Taewoo0927/Clean_bot/References/Self-learn/Makefile_Tutorial.txt

# Essential Makefile Codes for Embedded Projects: A Step-by-Step Guide

This tutorial lists the most important Makefile codes you need for creating a versatile Makefile, suitable for any microcontroller project without using an IDE.

---

## 1. Define the Compiler
```
CC = msp430-elf-gcc
```
- Specifies the compiler to use (`msp430-elf-gcc` for MSP430). Change this based on your microcontroller (e.g., `arm-none-eabi-gcc` for ARM Cortex).

---

## 2. Set the Microcontroller Model
```
MCU = msp430g2553
```
- Defines the specific microcontroller model. This is used in compiler and linker flags for device-specific settings.

---

## 3. Specify Include Paths
```
INCLUDE_PATH = C:/ti/msp430-gcc/include
CFLAGS = -I$(INCLUDE_PATH)
```
- Adds the directory where header files (e.g., `msp430.h`) are located. Adjust based on your toolchain's include directory.

---

## 4. Define Compiler Flags
```
CFLAGS += -mmcu=$(MCU) -Wall -O2
```
- Sets compiler options, such as specifying the MCU model (`-mmcu`), enabling all warnings (`-Wall`), and optimizing code (`-O2`).

---

## 5. Define Linker Flags
```
LDFLAGS = -T linker_script.ld
```
- Specifies linker options, including the custom linker script (`-T linker_script.ld`). This script controls memory layout.

---

## 6. List the Source Files
```
SRC = src/main.c src/adc.c src/i2c.c
```
- Defines all source files in the project. Add your `.c` files here.

---

## 7. Generate Object Files List
```
OBJ = $(SRC:.c=.o)
```
- Automatically generates the list of object files by replacing `.c` with `.o` in the source files list.

---

## 8. Define the Output Executable
```
TARGET = build/main.elf
```
- Specifies the output executable file (e.g., `main.elf`). Store it in a `build/` directory for organization.

---

## 9. Create the Build Directory
```
$(BUILD_DIR):
    mkdir -p $(BUILD_DIR)
```
- Creates the build directory if it does not already exist. This is helpful for organizing compiled files.

---

## 10. Compile Source Files into Object Files
```
%.o: %.c
    $(CC) $(CFLAGS) -c $< -o $@
```
- Compiles each `.c` file into an object file (`.o`). The `$<` is the input file, and `$@` is the output file.

---

## 11. Link Object Files into Executable
```
$(TARGET): $(OBJ)
    $(CC) $(CFLAGS) $(LDFLAGS) -o $(TARGET) $(OBJ)
```
- Links all object files into the final executable (`.elf` file).

---

## 12. Convert ELF File to HEX or TI-TXT Format
```
HEX_FILE = build/main.hex
$(HEX_FILE): $(TARGET)
    msp430-elf-objcopy -O ihex $(TARGET) $(HEX_FILE)
```
- Converts the ELF file to Intel HEX format (`.hex`) or TI-TXT format (`.txt`) for flashing.

---

## 13. Flash the Microcontroller
```
flash: $(HEX_FILE)
    C:/ti/MSPFlasher_1.3.20/MSP430Flasher.exe -n $(MCU) -w $(HEX_FILE) -v -g
```
- Uses the flasher tool to upload the HEX or TXT file to the microcontroller.

---

## 14. Clean Up Build Files
```
clean:
    rm -f $(OBJ) $(TARGET) $(HEX_FILE)
```
- Deletes all generated files (object files, ELF file, HEX file) to start a fresh build.

---

## 15. Force Rebuild of All Files
```
.PHONY: clean all
```
- Ensures that `clean` and `all` targets are always executed, even if files with the same names exist.

---

# Bonus Tips: Adding Custom Flags for Debugging

## 16. Enable Debugging Symbols
```
CFLAGS += -g
```
- Adds debugging information to the compiled code, making it easier to debug with tools like GDB.

---

## 17. Enable Verbose Output
```
VERBOSE = 1
$(TARGET): $(OBJ)
    $(CC) $(CFLAGS) $(LDFLAGS) -o $(TARGET) $(OBJ)
ifeq ($(VERBOSE), 1)
    @echo "Linking complete: $(TARGET)"
endif
```
- Prints additional information during the build process if `VERBOSE` is set to `1`.

---

# Summary
These Makefile codes provide a comprehensive and flexible setup for any microcontroller project, allowing you to:
- Compile, link, and flash your code without an IDE.
- Easily adjust the compiler, source files, and flags for different microcontrollers.
- Organize your project files efficiently and automate the build process.

With these commands, you can quickly set up and build embedded projects using just the terminal, giving you a lightweight and portable development workflow.
