Taewoo0927/Clean_bot/PCB_design/clean_bot/CAD_IMG/Final pcb.png

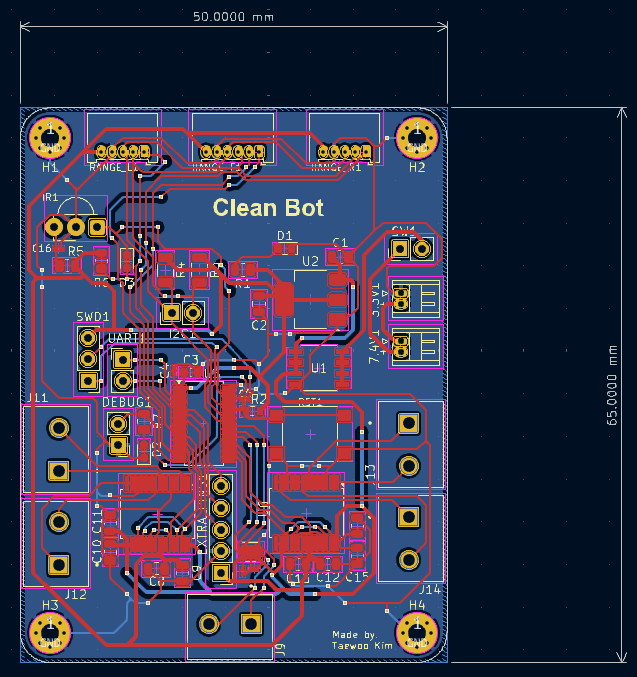
PCB_design/clean_bot/CAD_IMG/Final pcb.png
