Taewoo0927/Clean_bot/References/Code-Architecture/Code-Architecture.jpg

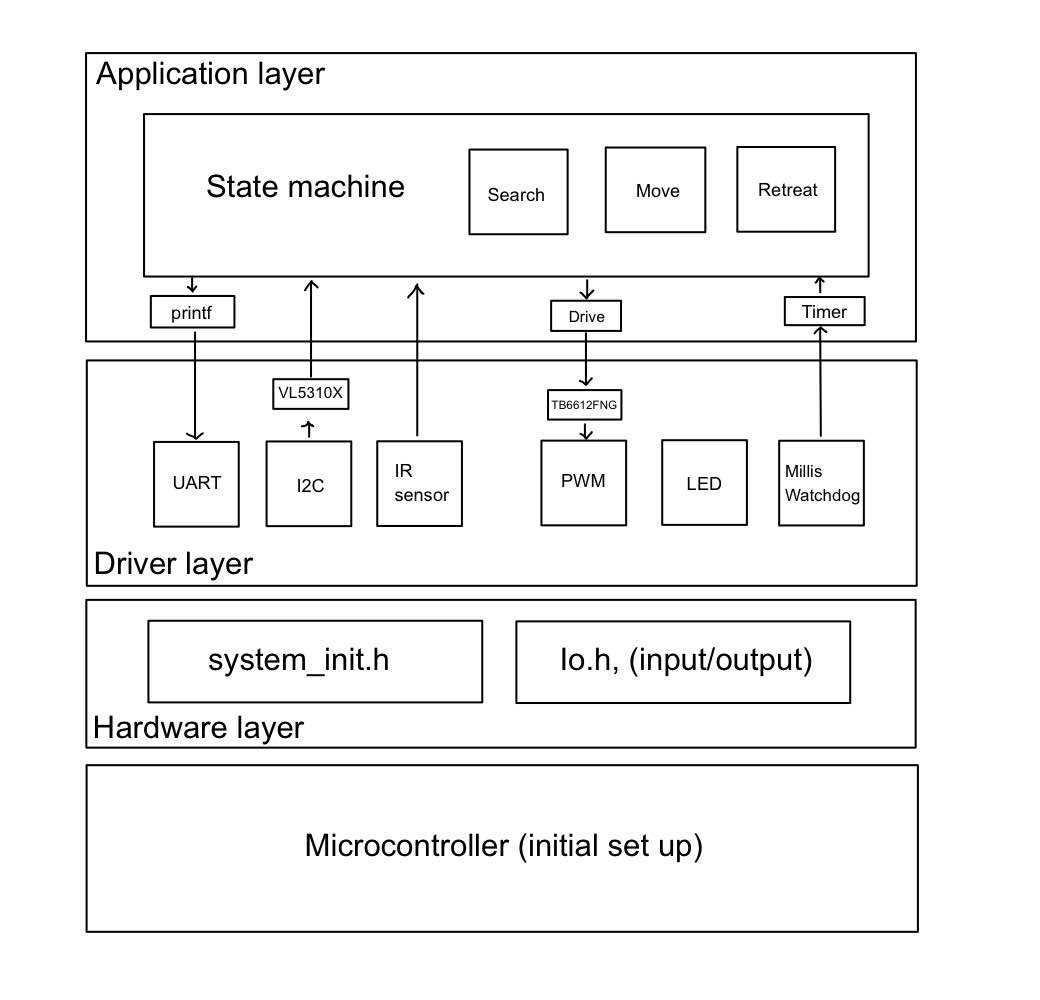
References/Code-Architecture/Code-Architecture.jpg
