Taewoo0927/Clean_bot/PCB_design/clean_bot/clean_bot.kicad_pcb

## KiCad design PCB_design/clean_bot/clean_bot.kicad_pcb (2024-11-16)

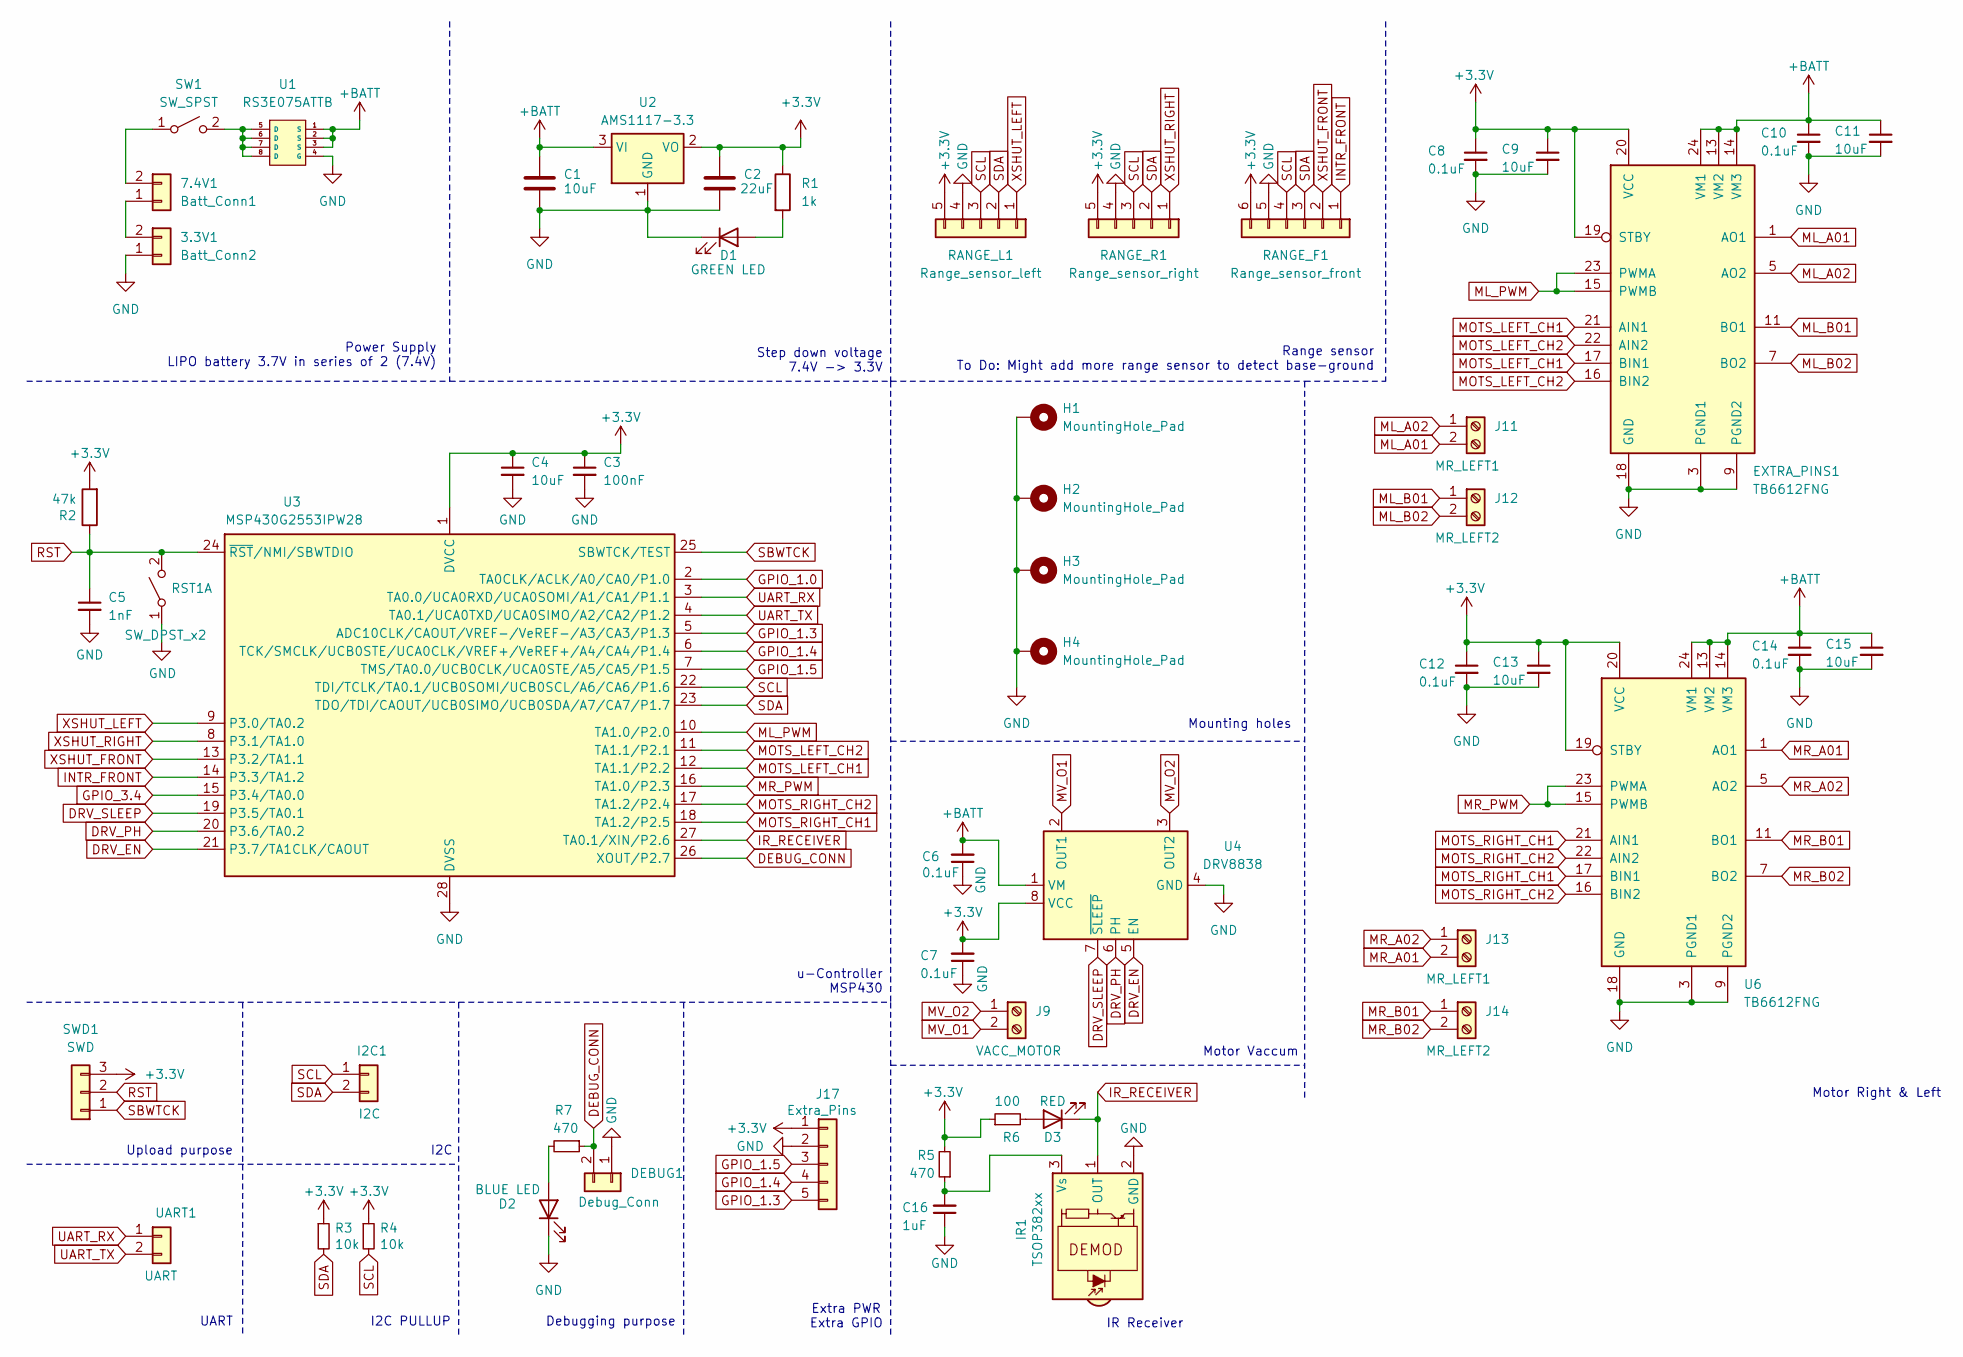
[picture p3: schematic clean_bot.kicad_sch]

Parts:
3.3V1: Batt_Conn2; Hirose_DF13-02P-1.25DS_1x02_P1.25mm_Horizontal
7.4V1: Batt_Conn1; Hirose_DF13-02P-1.25DS_1x02_P1.25mm_Horizontal
C1: 10uF; C_0805_2012Metric
C2: 22uF; C_0805_2012Metric
C3: 100nF; C_0603_1608Metric
C4: 10uF; C_0201_0603Metric
C5: 1nF; C_0201_0603Metric
C6, C7: 0.1uF; C_0201_0603Metric
C8, C10, C12, C14: 0.1uF; C_0805_2012Metric; LCSC Part C49678
C9, C11, C13, C15: 10uF; C_0805_2012Metric; LCSC Part C15850
C16: 1uF; C_0201_0603Metric
D1: GREEN LED; LED_0603_1608Metric
D2: BLUE LED; LED_0603_1608Metric
D3: RED; LED_0603_1608Metric; LCSC Part C2286
DEBUG1: Debug_Conn; PinHeader_1x02_P2.54mm_Vertical
EXTRA_PINS1: TB6612FNG; SSOP-24_5.3x8.2mm_P0.65mm
H1, H2, H3, H4: MountingHole_Pad; MountingHole_2.2mm_M2_Pad_Via
I2C1: I2C; PinHeader_1x02_P2.54mm_Vertical
IR1: TSOP382xx; Vishay_MINICAST-3Pin
J9: VACC_MOTOR; CUI_TB002-500-02BE
J11, J13: MR_LEFT1; CUI_TB002-500-02BE
J12, J14: MR_LEFT2; CUI_TB002-500-02BE
J17: Extra_Pins; PinHeader_1x05_P2.54mm_Vertical
R1: 1k; R_0805_2012Metric
R2: 47k; R_0603_1608Metric; LCSC Part C25819
R3, R4: 10k; R_1206_3216Metric; LCSC Part C17902
R5, R7: 470; R_0805_2012Metric; LCSC Part C17710
R6: 100; R_0805_2012Metric; LCSC Part C17408
RANGE_F1: Range_sensor_front; Molex_PicoBlade_53048-0610_1x06_P1.25mm_Horizontal
RANGE_L1: Range_sensor_left; Molex_PicoBlade_53048-0510_1x05_P1.25mm_Horizontal
RANGE_R1: Range_sensor_right; Molex_PicoBlade_53048-0510_1x05_P1.25mm_Horizontal
RST1: SW_DPST_x2; SW_Push_1P1T_NO_6x6mm_H9.5mm
SW1: SW_SPST; PinHeader_1x02_P2.54mm_Vertical
SWD1: SWD; PinHeader_1x03_P2.54mm_Vertical
U1: RS3E075ATTB; TRANS_RRH040P_ROM
U2: AMS1117-3.3; SOT-223-3_TabPin2
U3: MSP430G2553IPW28; TSSOP-28_4.4x9.7mm_P0.65mm
U4: DRV8838; WSON-8-1EP_2x2mm_P0.5mm_EP0.9x1.6mm
U6: TB6612FNG; SSOP-24_5.3x8.2mm_P0.65mm
UART1: UART; PinHeader_1x02_P2.54mm_Vertical

Connections:
+3.3V: C2.1, C3.1, C4.1, C7.2, C8.1, C9.1, C12.1, C13.1, EXTRA_PINS1.19 (STBY), EXTRA_PINS1.20 (VCC), J17.1, R1.1, R2.2, R3.1, R4.1, R5.2, R6.1, RANGE_F1.6, RANGE_L1.5, RANGE_R1.5, SWD1.3, U2.2 (VO), U3.1 (DVCC), U4.8 (VCC), U6.19 (STBY), U6.20 (VCC)
+BATT: C1.1, C6.2, C10.1, C11.1, C14.1, C15.1, EXTRA_PINS1.13 (VM2), EXTRA_PINS1.14 (VM3), EXTRA_PINS1.24 (VM1), U1.1 (S), U1.2 (S), U1.3 (S), U2.3 (VI), U4.1 (VM), U6.13 (VM2), U6.14 (VM3), U6.24 (VM1)
DEBUG_CONN: DEBUG1.2, R7.1, U3.26 (XOUT/P2.7)
DRV_EN: U3.21 (P3.7/TA1CLK/CAOUT), U4.5 (EN)
DRV_PH: U3.20 (P3.6/TA0.2), U4.6 (PH)
DRV_SLEEP: U3.19 (P3.5/TA0.1), U4.7 (~SLEEP)
GND: 3.3V1.1, C1.2, C2.2, C3.2, C4.2, C5.2, C6.1, C7.1, C8.2, C9.2, C10.2, C11.2, C12.2, C13.2, C14.2, C15.2, C16.1, D1.1 (K), D2.1 (K), DEBUG1.1, EXTRA_PINS1.3 (PGND1), EXTRA_PINS1.4 (PGND1), EXTRA_PINS1.9 (PGND2), EXTRA_PINS1.10 (PGND2), EXTRA_PINS1.18 (GND), H1.1, H2.1, H3.1, H4.1, IR1.2 (GND), J17.2, RANGE_F1.5, RANGE_L1.4, RANGE_R1.4, RST1.1 (A), U1.4 (G), U2.1 (GND), U3.28 (DVSS), U4.4 (GND), U4.9 (GND), U6.3 (PGND1), U6.4 (PGND1), U6.9 (PGND2), U6.10 (PGND2), U6.18 (GND)
GPIO_1.0: U3.2 (TA0CLK/ACLK/A0/CA0/P1.0)
GPIO_1.3: J17.5, U3.5 (ADC10CLK/CAOUT/VREF-/VeREF-/A3/CA3/P1.3)
GPIO_1.4: J17.4, U3.6 (TCK/SMCLK/UCB0STE/UCA0CLK/VREF+/VeREF+/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)
GPIO_1.5: J17.3, U3.7 (TMS/TA0.0/UCB0CLK/UCA0STE/A5/CA5/P1.5)
GPIO_3.4: U3.15 (P3.4/TA0.0)
INTR_FRONT: RANGE_F1.1, U3.14 (P3.3/TA1.2)
IR_RECEIVER: D3.1 (K), IR1.1 (OUT), U3.27 (TA0.1/XIN/P2.6)
ML_A01: EXTRA_PINS1.1 (AO1), EXTRA_PINS1.2 (AO1), J11.2
ML_A02: EXTRA_PINS1.5 (AO2), EXTRA_PINS1.6 (AO2), J11.1
ML_B01: EXTRA_PINS1.11 (BO1), EXTRA_PINS1.12 (BO1), J12.1
ML_B02: EXTRA_PINS1.7 (BO2), EXTRA_PINS1.8 (BO2), J12.2
ML_PWM: EXTRA_PINS1.15 (PWMB), EXTRA_PINS1.23 (PWMA), U3.10 (TA1.0/P2.0)
MOTS_LEFT_CH1: EXTRA_PINS1.17 (BIN1), EXTRA_PINS1.21 (AIN1), U3.12 (TA1.1/P2.2)
MOTS_LEFT_CH2: EXTRA_PINS1.16 (BIN2), EXTRA_PINS1.22 (AIN2), U3.11 (TA1.1/P2.1)
MOTS_RIGHT_CH1: U3.18 (TA1.2/P2.5), U6.17 (BIN1), U6.21 (AIN1)
MOTS_RIGHT_CH2: U3.17 (TA1.2/P2.4), U6.16 (BIN2), U6.22 (AIN2)
MR_A01: J13.2, U6.1 (AO1), U6.2 (AO1)
MR_A02: J13.1, U6.5 (AO2), U6.6 (AO2)
MR_B01: J14.1, U6.11 (BO1), U6.12 (BO1)
MR_B02: J14.2, U6.7 (BO2), U6.8 (BO2)
MR_PWM: U3.16 (TA1.0/P2.3), U6.15 (PWMB), U6.23 (PWMA)
MV_O1: J9.2, U4.2 (OUT1)
MV_O2: J9.1, U4.3 (OUT2)
unnamed: 3.3V1.2, 7.4V1.1
unnamed: 7.4V1.2, SW1.1 (A)
unnamed: D1.2 (A), R1.2
unnamed: D2.2 (A), R7.2
unnamed: D3.2 (A), R6.2
unnamed: C16.2, IR1.3 (Vs), R5.1
unnamed: SW1.2 (B), U1.5 (D), U1.6 (D), U1.7 (D), U1.8 (D)
RST: C5.1, R2.1, RST1.2 (B), SWD1.2, U3.24 (~RST/NMI/SBWTDIO)
SBWTCK: SWD1.1, U3.25 (SBWTCK/TEST)
SCL: I2C1.1, R4.2, RANGE_F1.4, RANGE_L1.3, RANGE_R1.3, U3.22 (TDI/TCLK/TA0.1/UCB0SOMI/UCB0SCL/A6/CA6/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)
SDA: I2C1.2, R3.2, RANGE_F1.3, RANGE_L1.2, RANGE_R1.2, U3.23 (TDO/TDI/CAOUT/UCB0SIMO/UCB0SDA/A7/CA7/P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)
UART_RX: U3.3 (TA0.0/UCA0RXD/UCA0SOMI/A1/CA1/P1.1), UART1.1
UART_TX: U3.4 (TA0.1/UCA0TXD/UCA0SIMO/A2/CA2/P1.2), UART1.2
XSHUT_FRONT: RANGE_F1.2, U3.13 (P3.2/TA1.1)
XSHUT_LEFT: RANGE_L1.1, U3.9 (P3.0/TA0.2)
XSHUT_RIGHT: RANGE_R1.1, U3.8 (P3.1/TA1.0)

Notes on the sheet:
I2C
Motor Vaccum
Power Supply LIPO battery 3.7V in series of 2 (7.4V)
Extra PWR
UART
I2C PULLUP
Range sensor To Do: Might add more range sensor to detect base-ground
u-Controller MSP430
Upload purpose
Motor Right & Left
Debugging purpose
Extra GPIO
Step down voltage 7.4V -> 3.3V
IR Receiver
Mounting holes

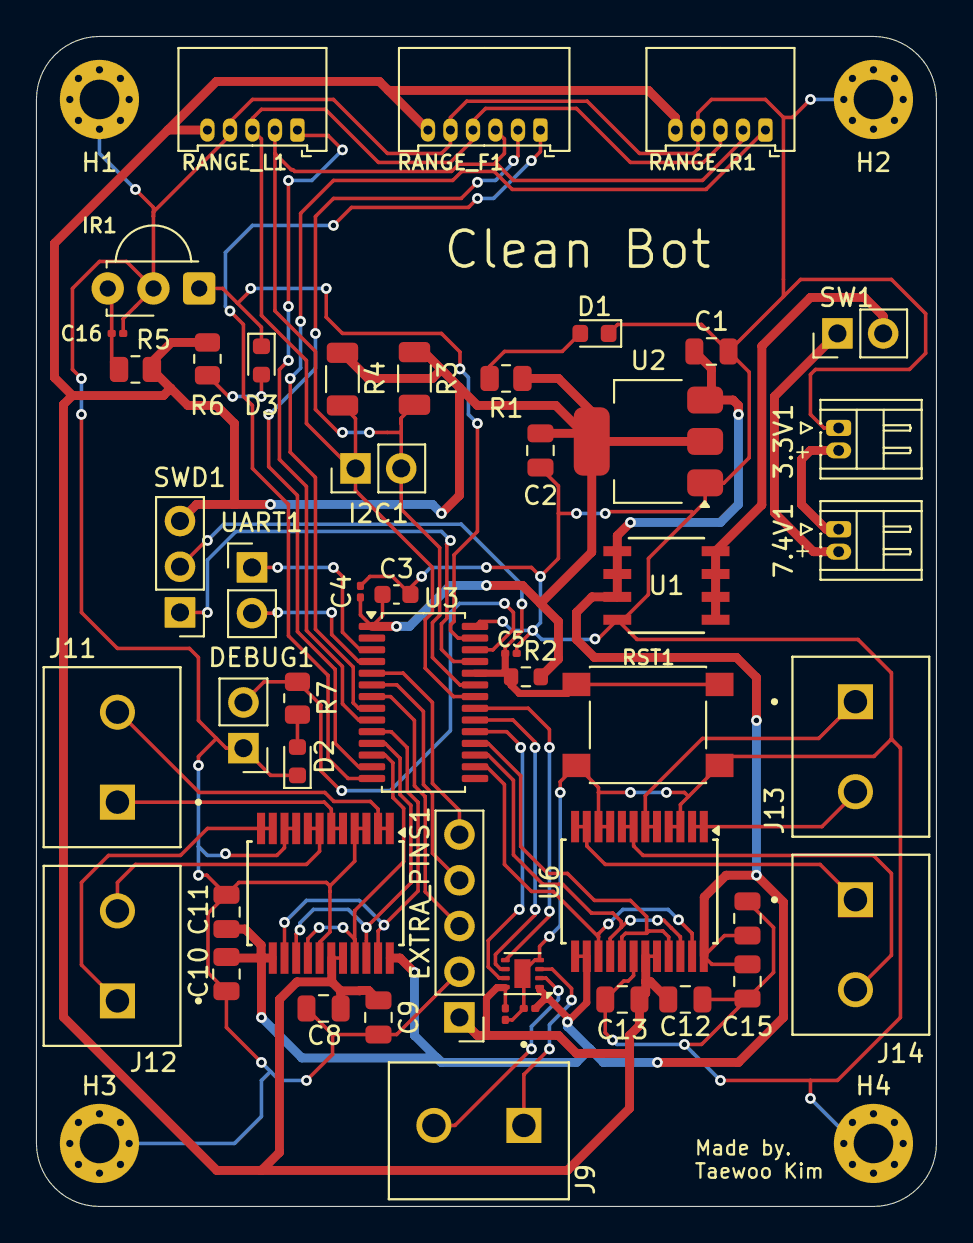
[picture p4: board clean_bot.kicad_pcb from above]

Board: 2 copper layers, 50.0 x 65.0 mm, 54 parts (0 on the bottom side), 44 nets.
