Taewoo0927/Clean_bot/References/unit_test/io_output/io_output_logic.png

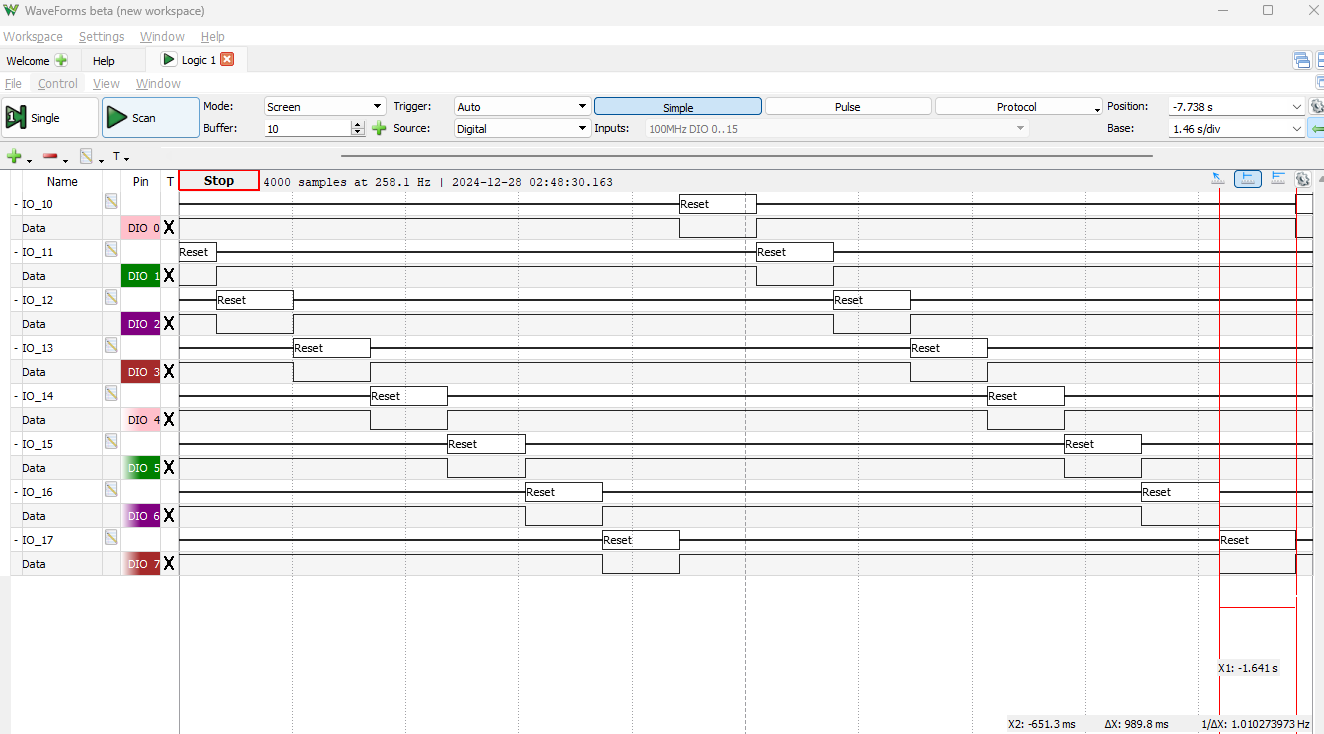
References/unit_test/io_output/io_output_logic.png
