Taewoo0927/Clean_bot/References/unit_test/led_blink_timing/perloop measurement.png

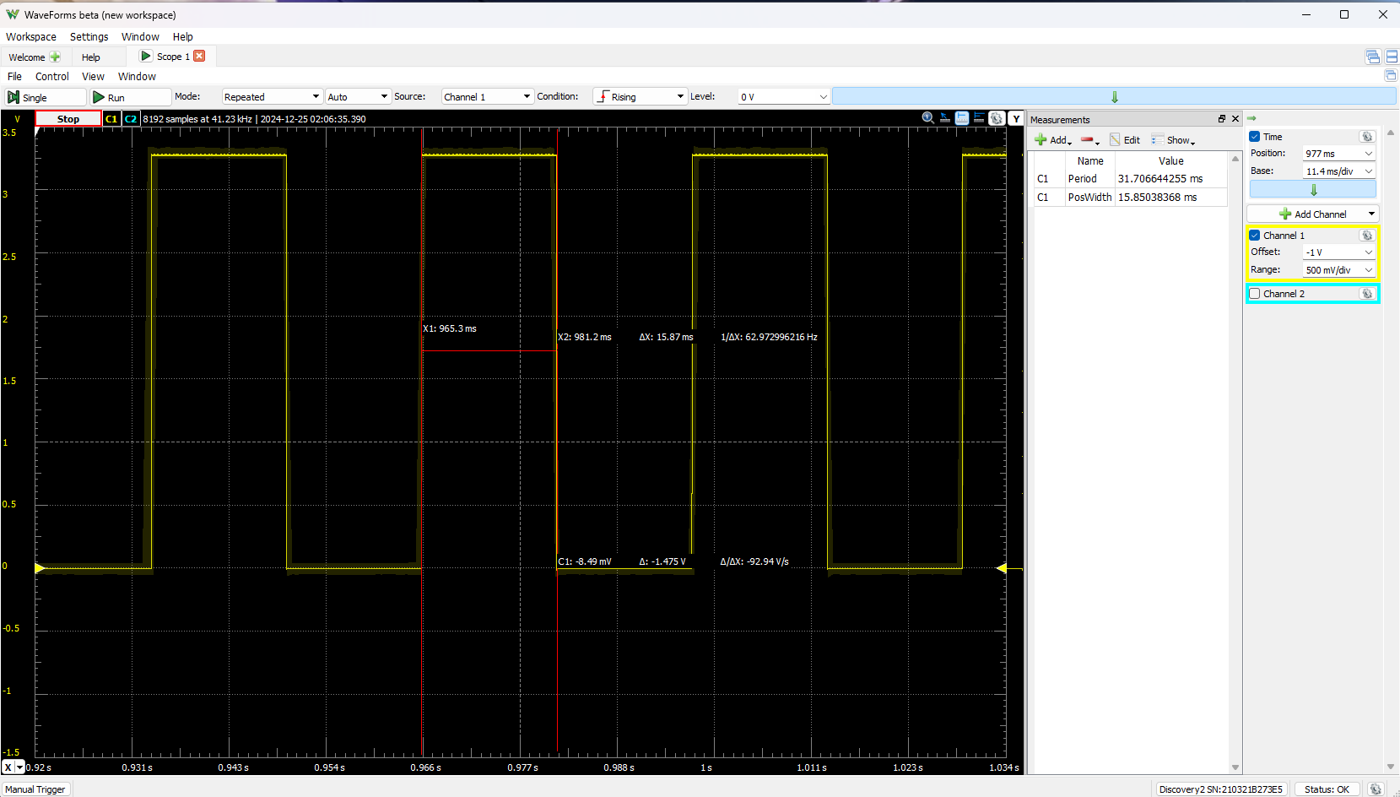
References/unit_test/led_blink_timing/perloop measurement.png
