Taewoo0927/Clean_bot/Src/Drivers/system_init.c

#include <msp430.h>
#include "Drivers/system_init.h"
#include "Drivers/io.h"

static void stop_watchdog(void)
{
    WDTCTL = WDTPW | WDTHOLD; // stop watchdog timer
}
void system_init(void)
{
    stop_watchdog();
    io_init();
}
