Taewoo0927/Clean_bot/(commit log)

2024-11-16 <PCB> Commiting pcb designs for clean bot
    [clean_bot.kicad_pcb, clean_bot.kicad_sch]
2024-11-17 <Foundation files> 1. main.c : testing with blinking LED 2. json files : tasks to use run commands, updaed include linker script paths. 3. Makefile : to intergrate commands that will be called from t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
2024-11-21 Create ci.yml
    <Ci.yml>
    1. Need to figure out how I can set tool chains for msp430
2024-12-28 <io.h, to-do> 1. added io_sel and io_dir register blocks in the header file. 2. added to-do list to track what I need to do
2024-12-28 <io.h, io.c> 1. Created io_set_sel function to choose which mode I want to use pin as. Also used Lookup table to optimize the function
    2. Organized reference folder
2024-12-28 <io.c> 1. Fixed #define IO_PORT(io) by subtraction 1, it is due to Lookuptable array indexing. 0 corresponds to P1 and 1 corresponds to P2 so after extracting port number it need to be subtracted by 1
    [io.c]
2024-12-28 <C99> 1. testing c99 error
    [io.c]
